riyassadiq11/ESP32_WITH_USB_C/Bottom_Layer (Img_Pdf_3D)/Bottom 3D View.pdf

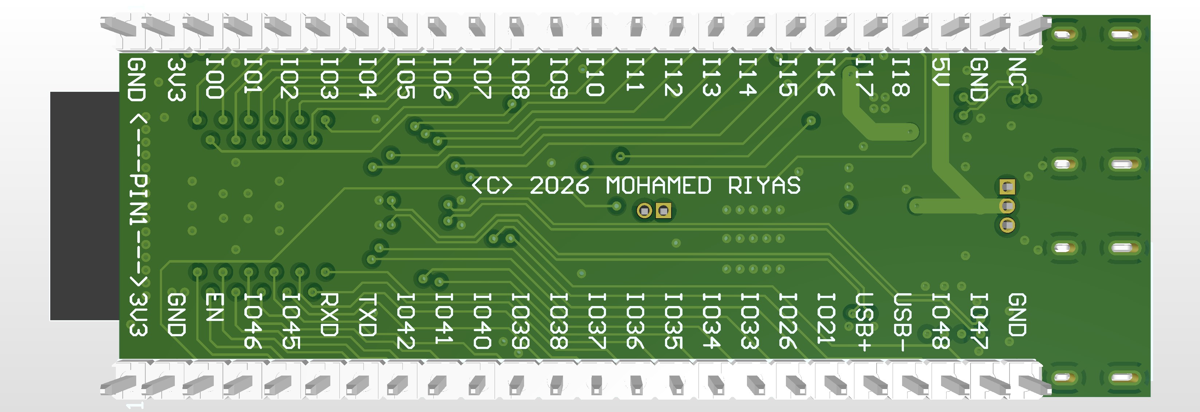
[picture p6: figure]
