riyassadiq11/ESP32_WITH_USB_C/Top_Layer (Img_Pdf_3D)/Top 3D View.pdf

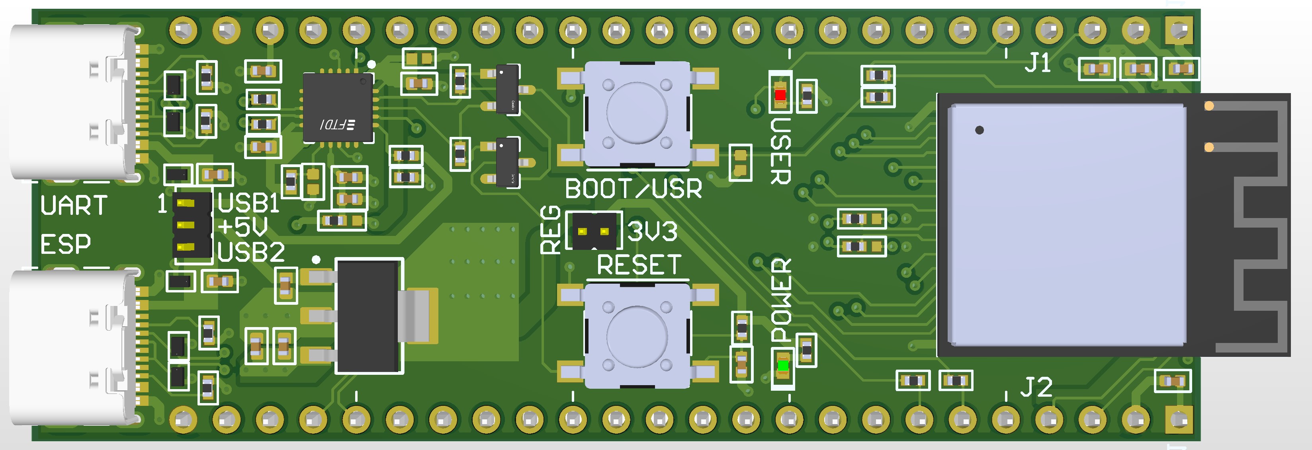
[picture p7: figure]
