riyassadiq11/ESP32_WITH_USB_C/Project Outputs for ESP32_WITH_USB_C/BOM/Bill of Materials-ESP32_WITH_USB_C(Prototype).csv

Comment | Description | Designator | Footprint | LibRef | Quantity | LCSC Part Number | Manufacturer | Manufacturer Part Number | Supplier | Supplier Part Number
100nF, 50V | CAP CER 0.1UF 50V X7R 0402 | C1, C3, C5, C6, C10, C11, C12, C13, C15 | CAPC1005X65N | CL05B104KB54PNC (2) | 9 | C307331 | Samsung Electro-Mechanics | CL05B104KB54PNC | DigiKey | 1276-CL05B104KB54PNCDKR-ND
4.7uF, 16V | CAP CER 4.7UF 16V X5R 0402 | C2, C9 | CAPC1005X65N | CL05A475MO5NUNC | 2 | C318563 | Samsung Electro-Mechanics | CL05A475MO5NUNC | DigiKey | 1276-6836-1-ND
10uF, 10V | CAP CER 10UF 10V X5R 0402 | C7, C8, C14 | CAPC1005X65N | CL05A106MP5NUNC | 3 | C315248 | Samsung Electro-Mechanics | CL05A106MP5NUNC | DigiKey | 1276-1450-1-ND
1uF, 35V | CAP CER 1UF 35V X5R 0402 | C16 | CAPC1005X65N | CL05A105KL5NRNC | 1 | C307413 | Samsung Electro-Mechanics | CL05A105KL5NRNC | DigiKey | 1276-6796-1-ND
AQ3045-01ETG | TVS DIODE 5.3VWM 12VC SOD882 | D1, D2, D5, D6, D7, D8 | RTVS_SOD882_LTF | AQ3045-01ETG | 6 | C3710326 | Littelfuse | AQ3045-01ETG | DigiKey | F9321CT-ND
GREEN | LED YLW-GRN 0402 SMD | D3 | LED_0402_G | VLMG1500-GS08 | 1 | C511404 | Vishay | VLMG1500-GS08 | DigiKey | VLMG1500-GS08TR-ND
RED | LED RED 0402 SMD | D4 | LED_0402_R | VLMS1500-GS08 | 1 | C511370+ | Vishay | VLMS1500-GS08 | DigiKey | VLMS1500-GS08TR-ND
22-28-4245 | CONN HEADER VERT 24POS 2.54MM | J1, J2 | HDR_1X24_2.45MM | 22-28-4245 | 2 | C7145888 | Molex | 22-28-4245 | Mouser | 538-22-28-4245
217179-0001 | CONN RCP USB2.0 TYP C 24P SMD RA | J3, J4 | 2171790001_MOL | 217179-0001 | 2 | C3197684 | Molex | 217179-0001 | DigiKey | 900-2171790001CT-ND
FTS-102-01-F-S | CONN HEADER VERT 2POS 1.27MM | J5 | HDR_1X2_1.27MM | FTS-102-01-F-S | 1 | C6045317 | Samtec | FTS-102-01-F-S | DigiKey | SAM15176-ND
FTS-103-01-F-S | CONN HEADER VERT 3POS 1.27MM | J6 | HDR_1X3_1.27MM | FTS-103-01-F-S | 1 | C3333578 | Samtec | FTS-103-01-F-S | DigiKey | 612-FTS-103-01-F-S-ND
M50-1920005 | CONN SHUNT 1.27MM RED | LINK1, LINK2 |  | M50-1920005 | 2 | C6985646 | Harwin | M50-1920005 | DigiKey | 952-1727-ND
SS8050-G | TRANS NPN 25V 1.5A SOT-23-3 | Q1, Q2 | FP-SS8050-G-IPC_B | SS8050-G | 2 | C3199946 | Comchip | SS8050-G | DigiKey | 641-1790-6-ND
0R | RES 0 OHM JUMPER 1/16W 0402 | R1, R8, R18, R19, R22, R23 | RESC1005X37N | RC0402JR-070RL | 6 | C60485 | Yageo Group | RC0402JR-070RL | DigiKey | 311-0.0JRCT-ND
5K1 | RES SMD 5.1K OHM 1% 1/16W 0402 | R4, R5, R13, R14 | RESC1005X37N | AC0402FR-075K1L | 4 | C144745 | Yageo Group | AC0402FR-075K1L | DigiKey | YAG3503DKR-ND
27R | RES 27 OHM 1% 1/16W 0402 | R6, R7, R16, R17 | RESC1005X37N | RC0402FR-0727RL | 4 | C138021 | Yageo Group | RC0402FR-0727RL | DigiKey | YAG3086DKR-ND
1K | RES 1K OHM 1% 1/16W 0402 | R9, R10 | RESC1005X37N | RC0402FR-071KL | 2 | C106235 | Yageo Group | RC0402FR-071KL | DigiKey | 311-1.00KLRDKR-ND
4K7 | RES 4.7K OHM 1% 1/16W 0402 | R11 | RESC1005X37N | RC0402FR-074K7L | 1 | C105871 | Yageo Group | RC0402FR-074K7L | DigiKey | 311-4.7KLRDKR-ND
10K | RES 10K OHM 1% 1/16W 0402 | R12, R15, R20, R21 | RESC1005X37N | RC0402FR-0710KL | 4 | C60490 | Yageo Group | RC0402FR-0710KL | DigiKey | 311-10.0KLRDKR-ND
PTS645SM50SMTR92 LFS | SWITCH TACTILE SPST-NO 0.05A 12V | SW1, SW2 | PTS645S_SMTR92_CNK | PTS645SM50SMTR92LFS | 2 | C221881 | C&K Components | PTS645SM50SMTR92LFS | DigiKey | CKN10889CT-ND
ESP32-S3-MINI-1-N8 | SMD module, ESP32-S3FN8, 8 MB SPI flash, PCB antenna | U1 | XCVR_ESP32-S3-MINI-1-N8 | ESP32-S3-MINI-1-N8 | 1 | C2913206 | Espressif Systems | ESP32-S3-MINI-1-N8 | DigiKey | 5407-ESP32-S3-MINI-1-N8DKR-ND
FT231XQ-R | IC USB SERIAL FULL UART 20QFN | U2 | FP-QFN-20-IPC_B | FT231XQ-R | 1 | C132159 | FTDI | FT231XQ-R | DigiKey | 768-1128-6-ND
TL1963A-33DCYR | IC REG LIN 3.3V 1.5A SOT-223-4 | U3 | DCY0004A_N | TL1963A-33DCYR | 1 | C181262 | Texas Instruments | TL1963A-33DCYR | DigiKey | 296-24897-2-ND
