riyassadiq11/ESP32_WITH_USB_C/3D_Step_File/User Library-LED_1006_R.STEP

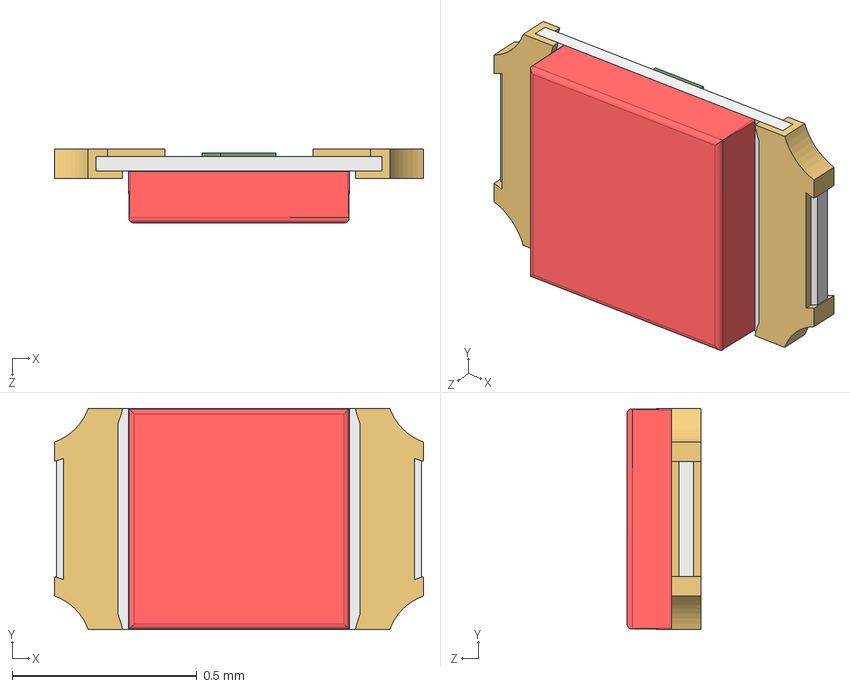
[picture p8: CAD file, 2026-11-05]
3D_Step_File/User Library-LED_1006_R.STEP
1.00 x 0.6 x 0.2 mm
Rot
Cut005_(Mirror_#1)
