riyassadiq11/ESP32_WITH_USB_C/3D_Step_File/PTS645SH50SMTR92_LFS.stp

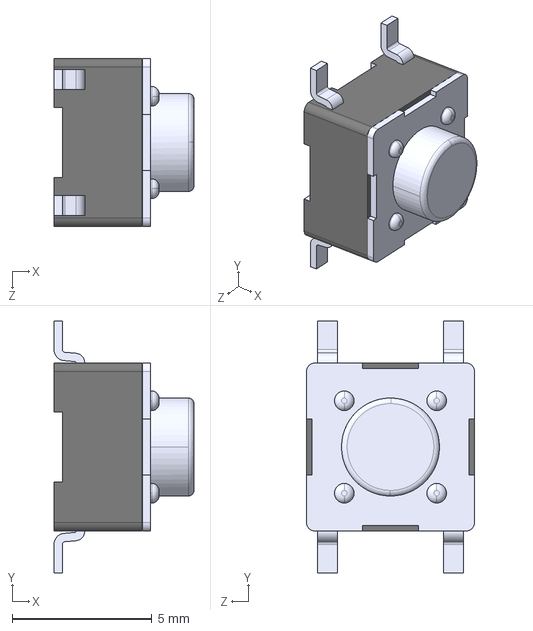
[picture p9: CAD file, 2026-11-05]
3D_Step_File/PTS645SH50SMTR92_LFS.stp
5.00 x 9.00 x 6.00 mm
