riyassadiq11/ESP32_WITH_USB_C/3D_Step_File/ESP32-S3-MINI-1-N8--3DModel-STEP-510211.STEP

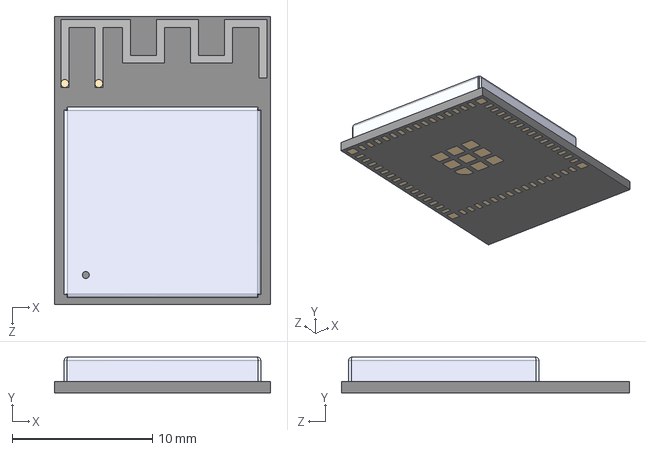
[picture p10: CAD file, 2026-11-05]
3D_Step_File/ESP32-S3-MINI-1-N8--3DModel-STEP-510211.STEP
15.4 x 2.55 x 20.5 mm
