riyassadiq11/ESP32_WITH_USB_C/3D_Step_File/RTVS_SOD882_LTF.step

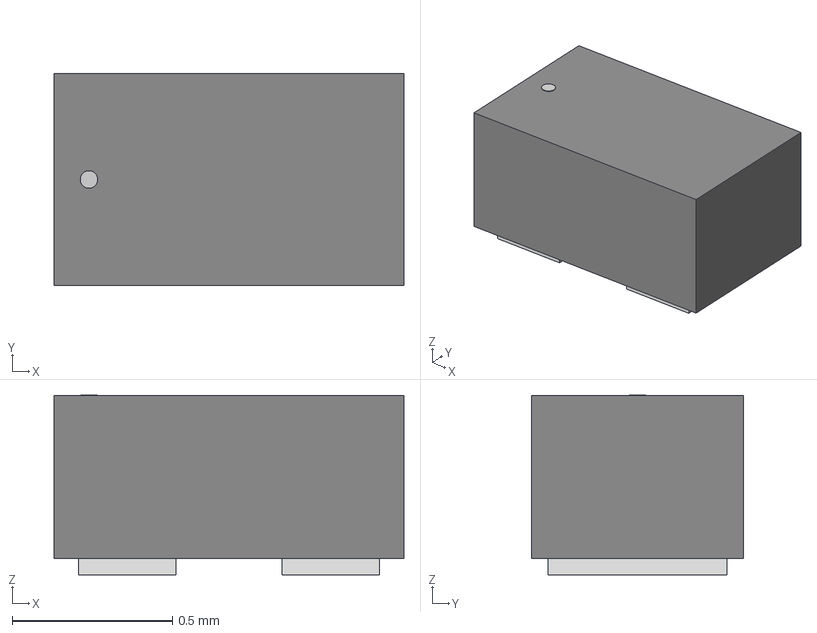
[picture p11: CAD file, 2026-11-05]
3D_Step_File/RTVS_SOD882_LTF.step
1.09 x 0.66 x 0.561 mm
