riyassadiq11/ESP32_WITH_USB_C/3D_Step_File/fts-102-01-f-s.stp

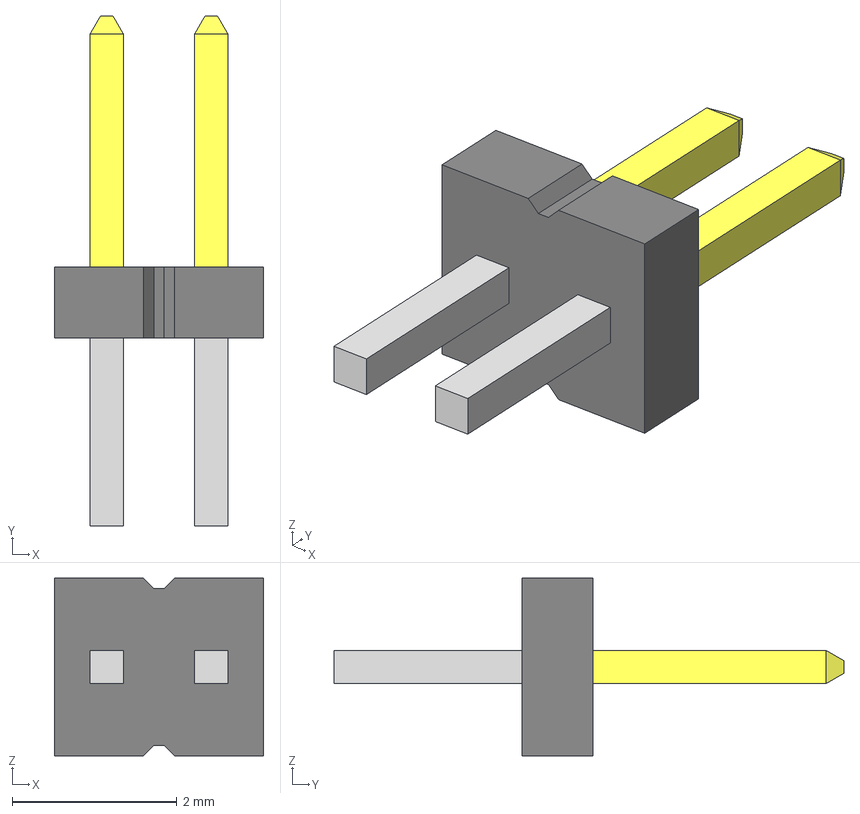
[picture p13: CAD file, 2026-11-05]
3D_Step_File/fts-102-01-f-s.stp
2.54 x 6.20 x 2.16 mm
