riyassadiq11/ESP32_WITH_USB_C/3D_Step_File/022284245.stp

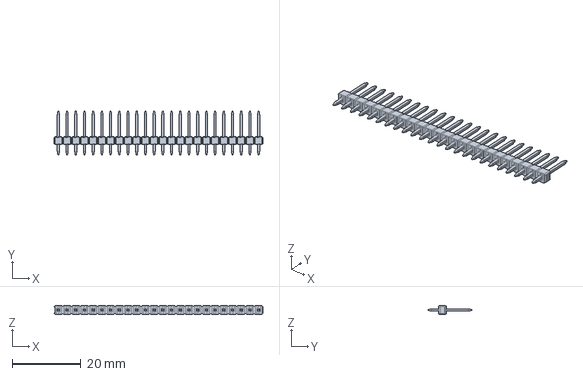
[picture p14: CAD file, 2026-11-05]
3D_Step_File/022284245.stp
61.0 x 12.8 x 2.49 mm
