riyassadiq11/ESP32_WITH_USB_C/3D_Step_File/2171790001.stp

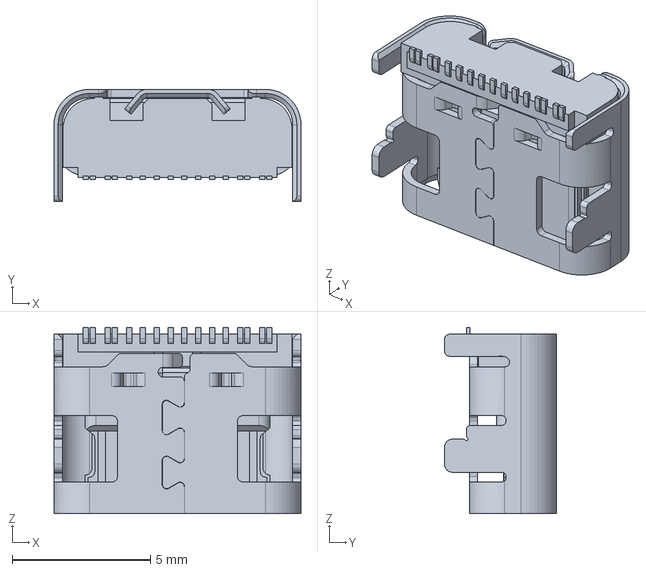
[picture p15: CAD file, 2026-11-05]
3D_Step_File/2171790001.stp
8.94 x 4.06 x 6.75 mm
