riyassadiq11/ESP32_WITH_USB_C/(list of files, cad)

Other CAD files:
3D_Step_File/User Library-LED_1006_G.STEP
