riyassadiq11/ESP32_WITH_USB_C/Schematic (Img_Pdf)/Schematic.pdf

# ESP32 WITH USB-C

# ESP32-S3-MINI

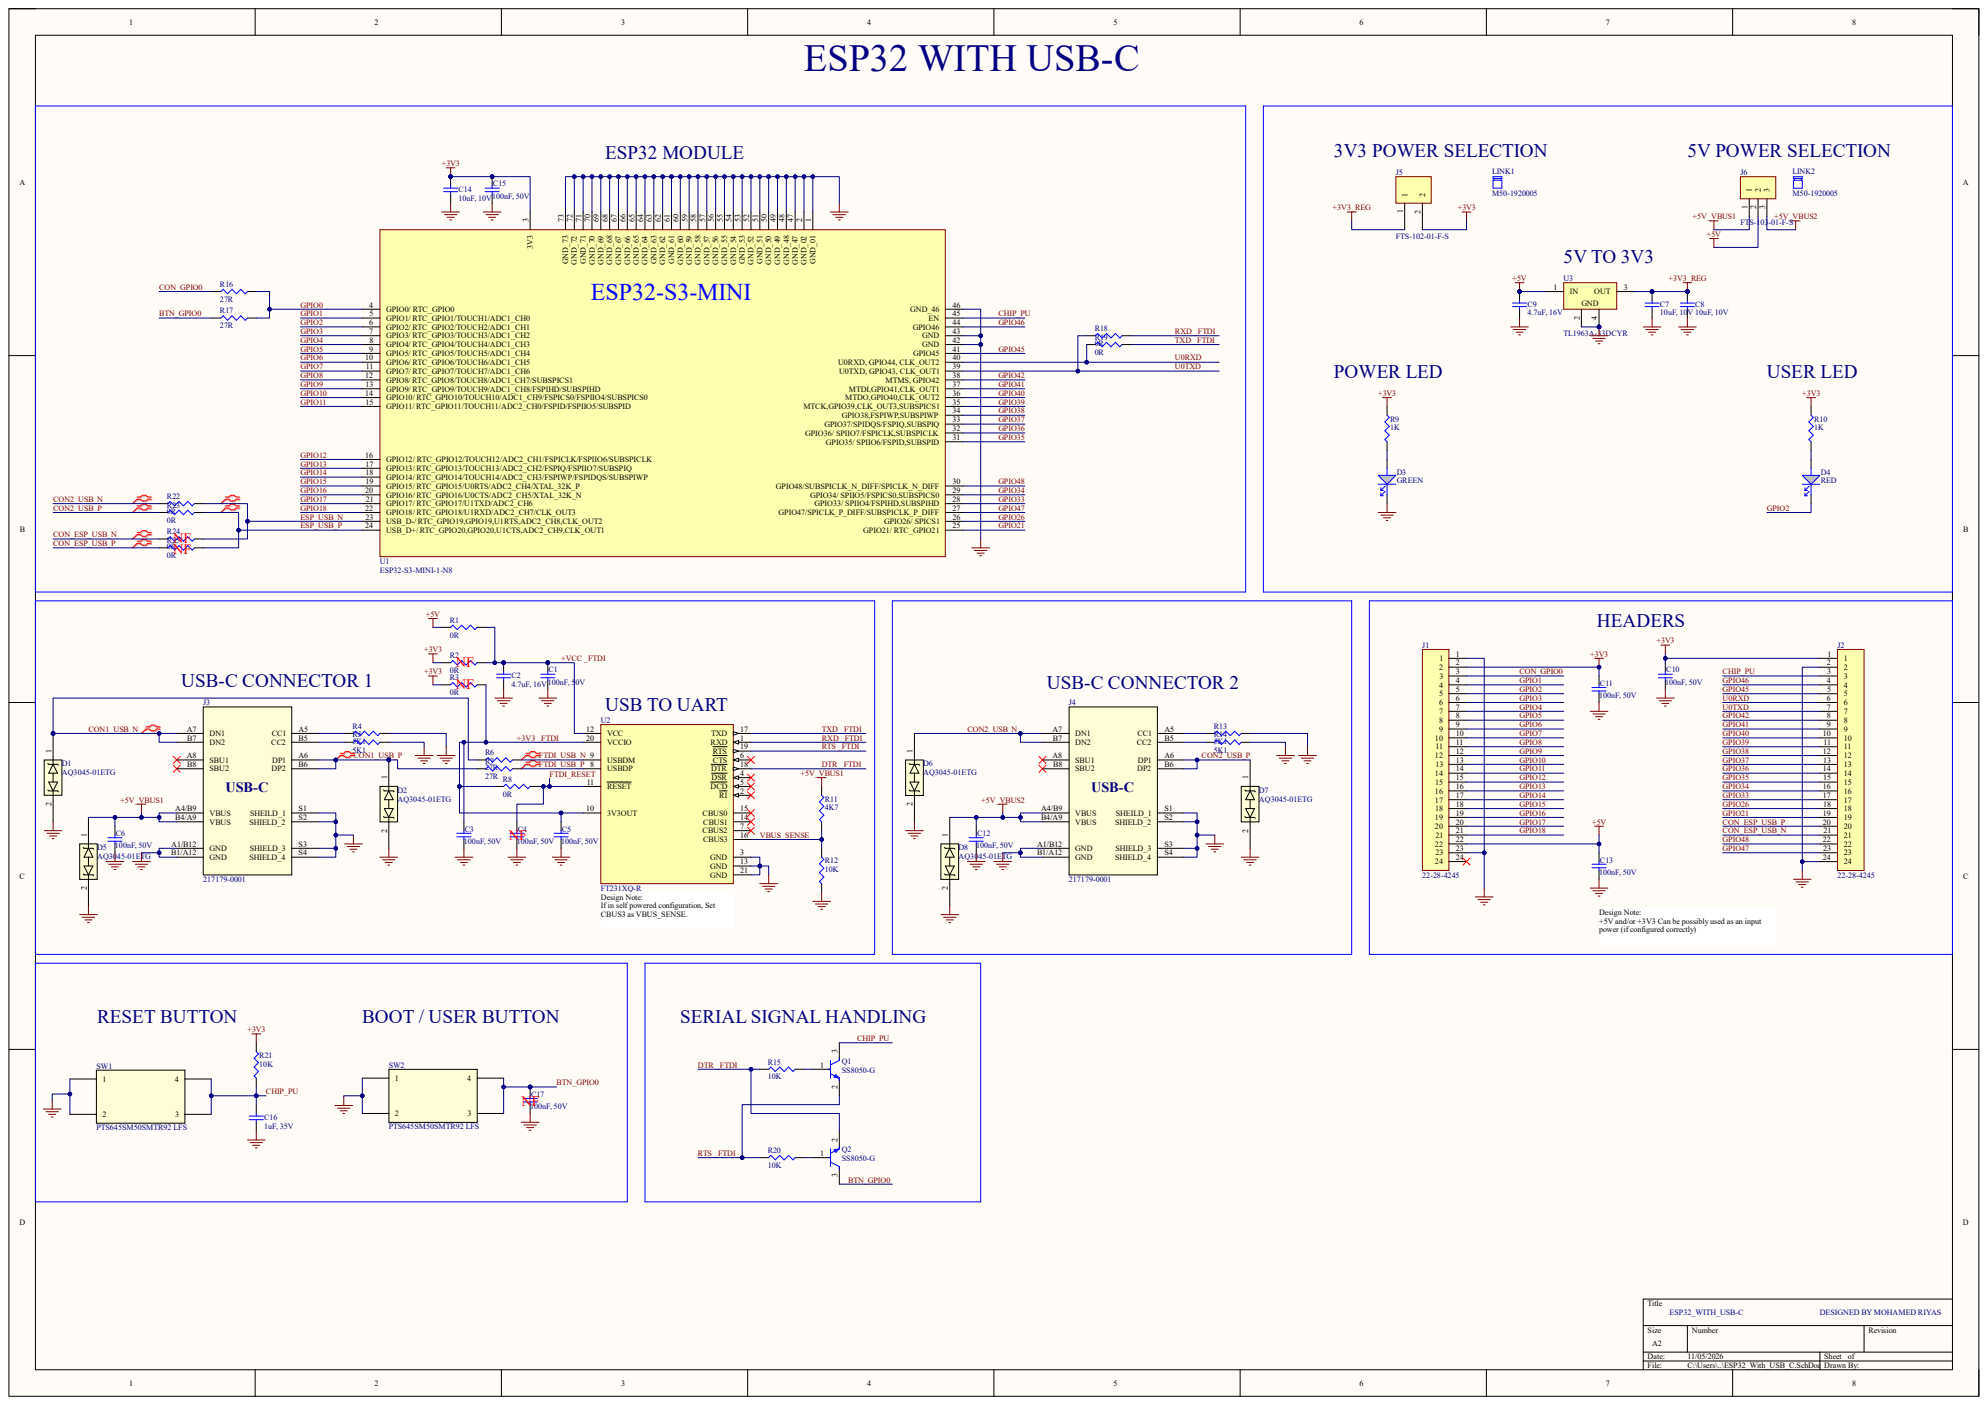
[picture p16: page 1]

Design Note:
If in self powered configuration, Set
CBUS3 as VBUS_SENSE.

+5V and/or +3V3 Can be possibly used as an input
power (if configured correctly)
