riyassadiq11/ESP32_WITH_USB_C/Bottom_Layer (Img_Pdf_3D)/Bottom Layer.pdf

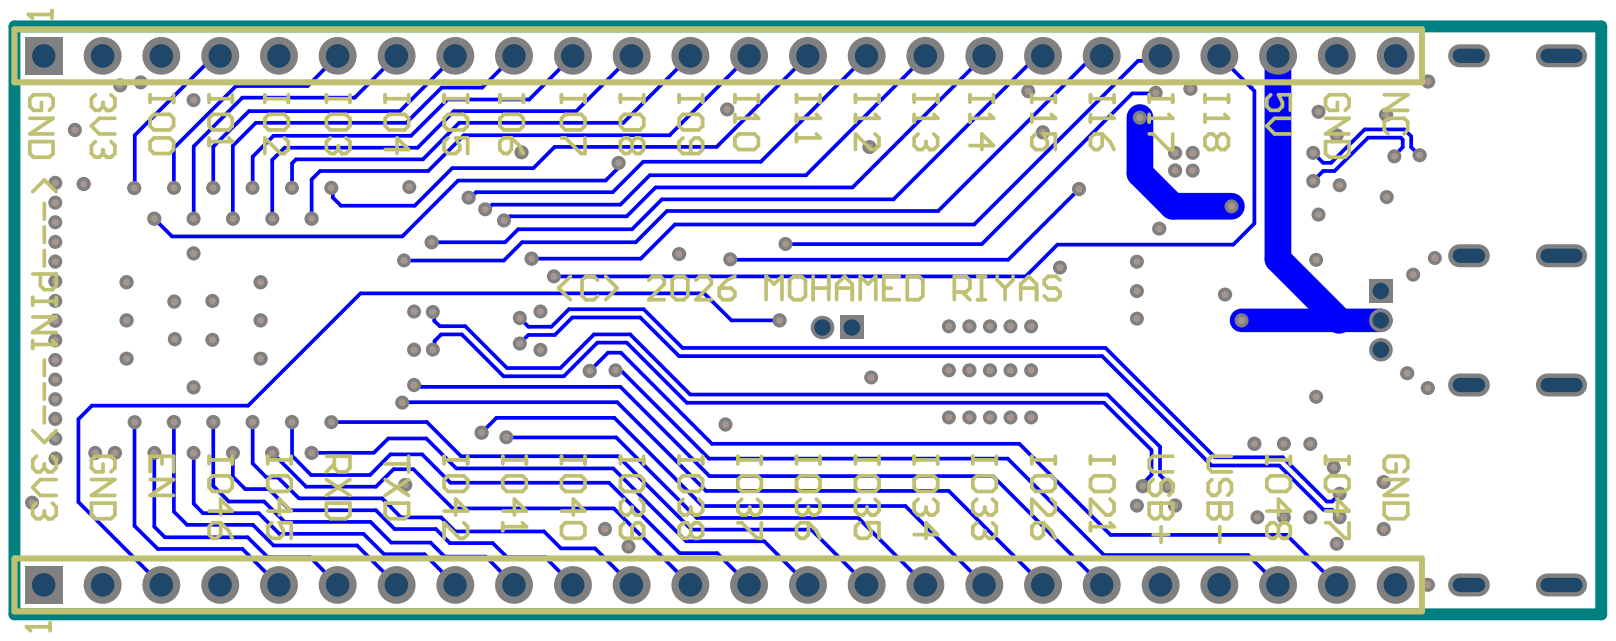
[picture p17: page 1]
