riyassadiq11/ESP32_WITH_USB_C/Top_Layer (Img_Pdf_3D)/Top Layer.pdf

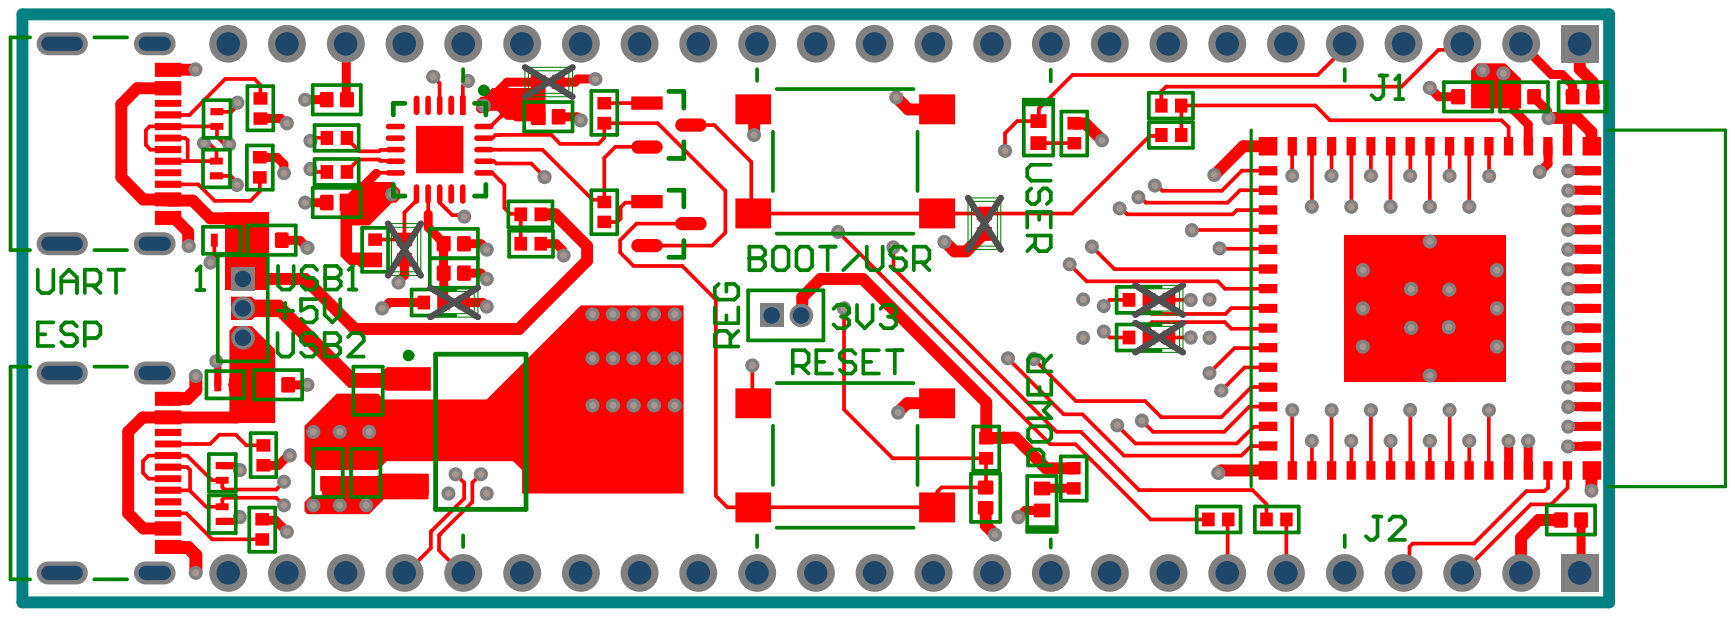
[picture p18: page 1]
