riyassadiq11/ESP32_WITH_USB_C/(list of files, drawings)

Other design files:
ESP32_With_USB_C.PcbDoc
ESP32_WITH_USB_C.PrjPcb
ESP32_With_USB_C.SchDoc
PcbLib.PcbLib
Schlib.SchLib
Symbol & Footrints/2171790001/2171790001.PcbLib
Symbol & Footrints/2171790001/2171790001.SchLib
Symbol & Footrints/AC0402FR-075K1L/AC0402FR-075K1L.SchLib
Symbol & Footrints/AC0402FR-075K1L/RESC1005X37N.PcbLib
Symbol & Footrints/AQ3045-01ETG/AQ3045-01ETG.PcbLib
Symbol & Footrints/AQ3045-01ETG/AQ3045-01ETG.SchLib
Symbol & Footrints/CL05A105KL5NRNC/CAPC1005X65N.PcbLib
Symbol & Footrints/CL05A105KL5NRNC/CL05A105KL5NRNC.SchLib
Symbol & Footrints/ESP32-S3-MINI-1-N8/ESP32-S3-MINI-1-N8.SchLib
Symbol & Footrints/ESP32-S3-MINI-1-N8/XCVR_ESP32-S3-MINI-1-N8.PcbLib
Symbol & Footrints/FT231XQ-R/FT231XQ-R.PcbLib
Symbol & Footrints/FT231XQ-R/FT231XQ-R.SchLib
Symbol & Footrints/PTS645SH50SMTR92LFS/PTS645SH50SMTR92LFS.PcbLib
Symbol & Footrints/PTS645SH50SMTR92LFS/PTS645SH50SMTR92LFS.SchLib
Symbol & Footrints/SS8050-G/SS8050-G.PcbLib
Symbol & Footrints/SS8050-G/SS8050-G.SchLib
Symbol & Footrints/TL1963A-33DCYR/TL1963A-33DCYR.PcbLib
Symbol & Footrints/TL1963A-33DCYR/TL1963A-33DCYR.SchLib
