riyassadiq11/ESP32_WITH_USB_C/(commit log)

2026-11-05 Enhance README with project details and learnings
    Added detailed project overview, hardware architecture, PCB layout specifications, and personal learning insights for the ESP32_WITH_USB_C development board.
2026-11-05 3D step files downloaded from external websites
    [022284245.stp, 2171790001.stp, ESP32-S3-MINI-1-N8--3DModel-STEP-510211.STEP, PTS645SH50SMTR92_LFS.stp, RTVS_SOD882_LTF.step, User Library-LED_1006_G.STEP, User Library-LED_1006_R.STEP, fts-102-01-f-s.stp]
2026-11-05 ESP32 pin details
    [ESP32_Pinout_Sheet.xlsx]
2026-11-05 Gerber_BOM_Pick&Place_NC Drill
    [Bill of Materials-ESP32_WITH_USB_C(Prototype).csv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]
2026-11-05 Add schematic image to README
    Added a schematic image to the README for better visualization.
2026-11-05 Enhance README with PCB and 3D view images
    Added PCB layout images and 3D views to the README.
